GwenDL98/Tesi-/(list of files, cad)

Other CAD files:
gripper_w_0.4.f3z
